SuprithiMarneedi/SELF-POWERED-PIEZOELECTRIC-ENERGY-HARVESTER/open lab poster.pdf

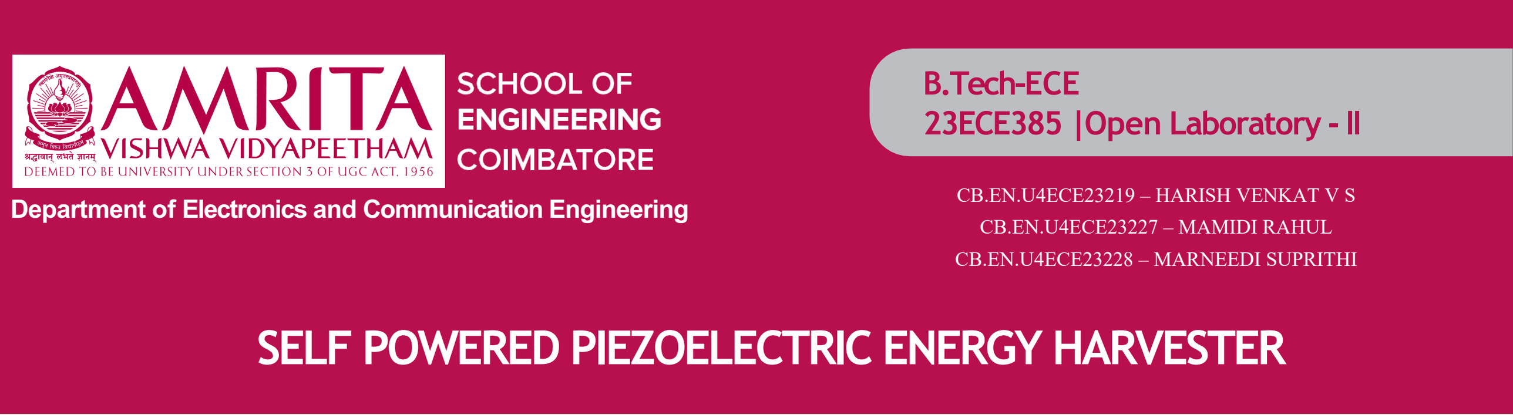
[picture p1: figure]
B.Tech–ECE 23ECE385 |Open Laboratory -II; CB.EN.U4ECE23219 – HARISH VENKAT V S CB.EN.U4ECE23227 – MAMIDI RAHUL CB.EN.U4ECE23228 – MARNEEDI SUPRITHI

# SELF POWERED PIEZOELECTRIC ENERGY HARVESTER

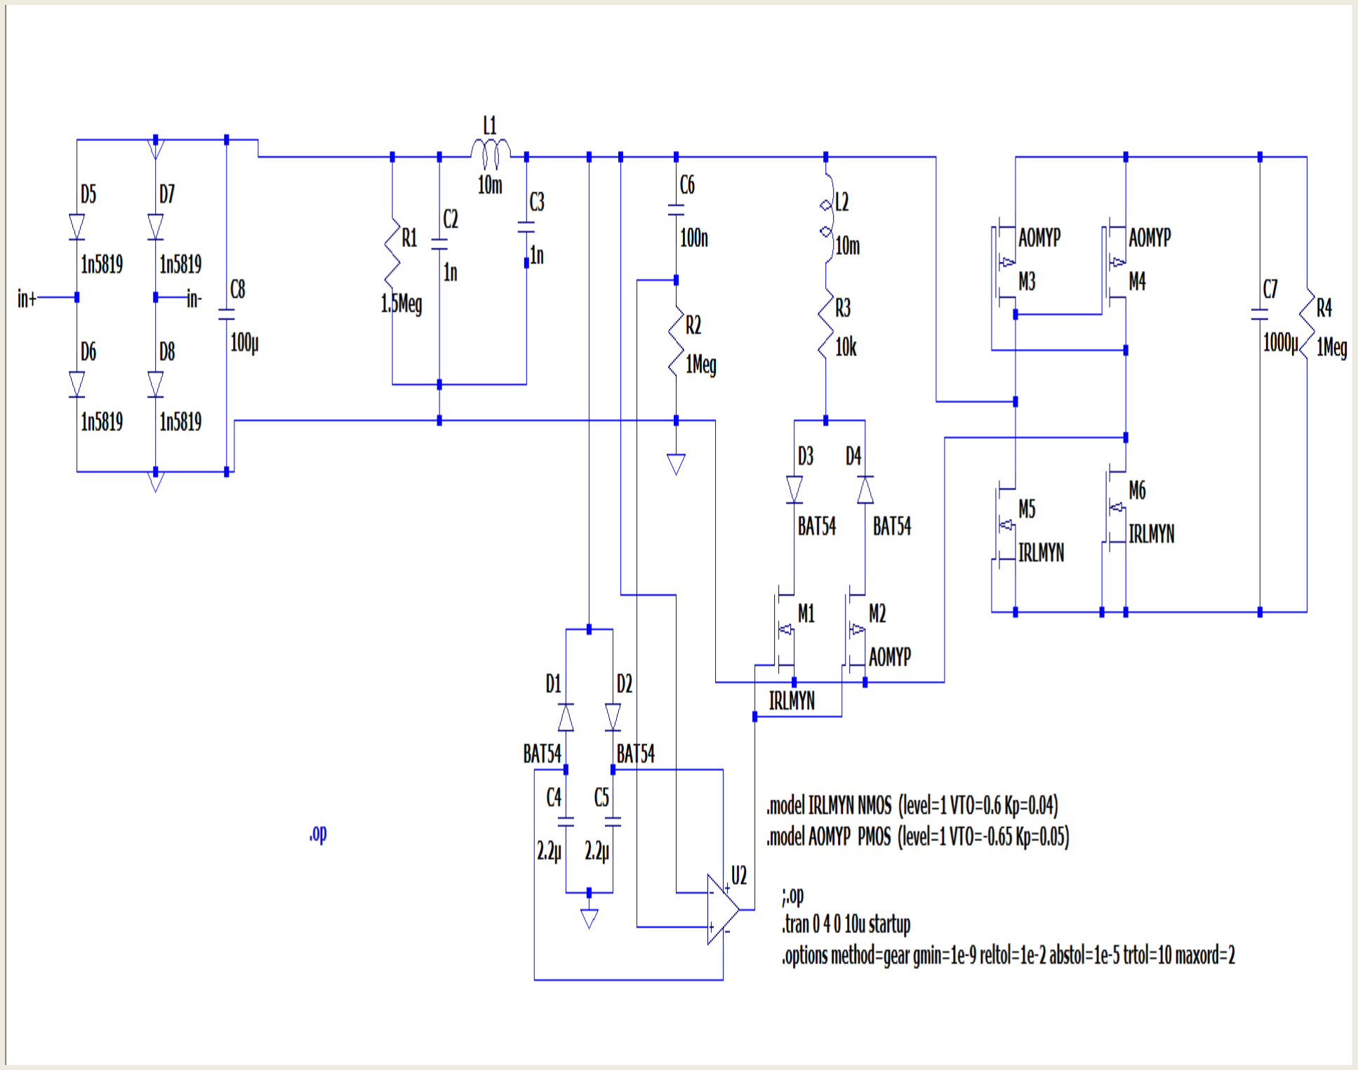
[picture p2: figure]
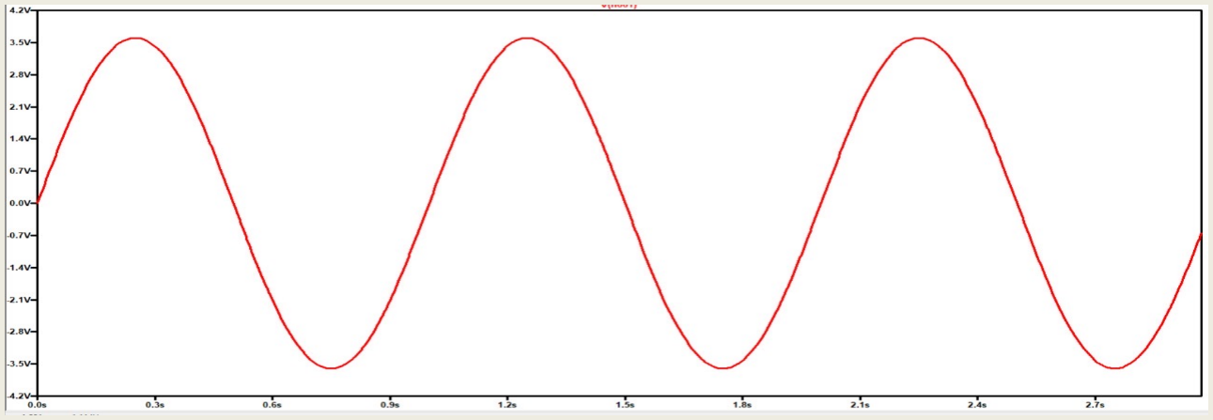
[picture p3: figure]
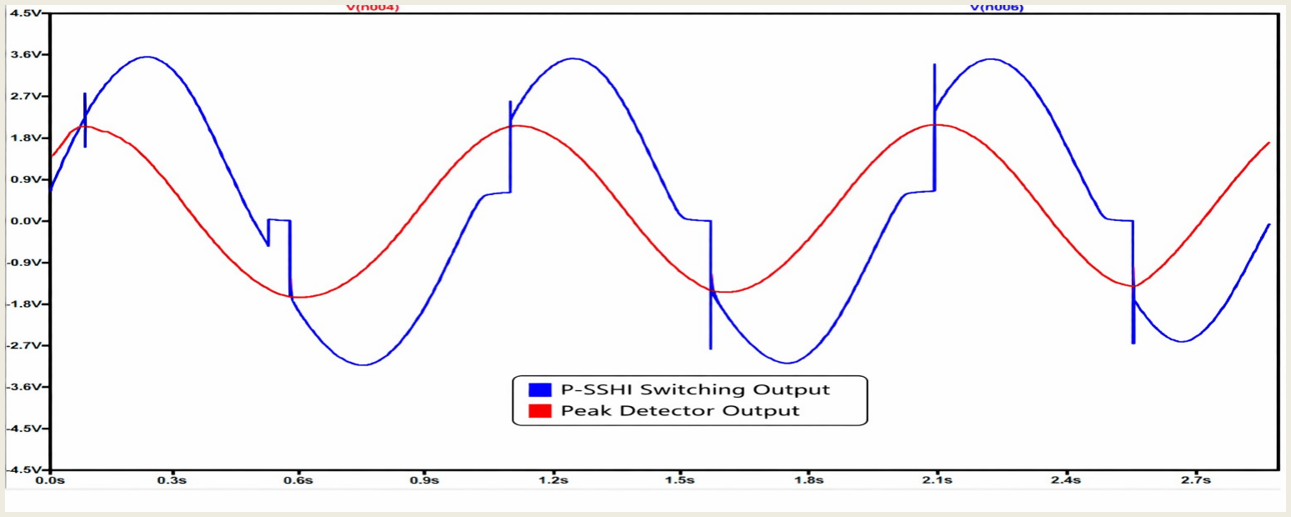
[picture p4: figure]
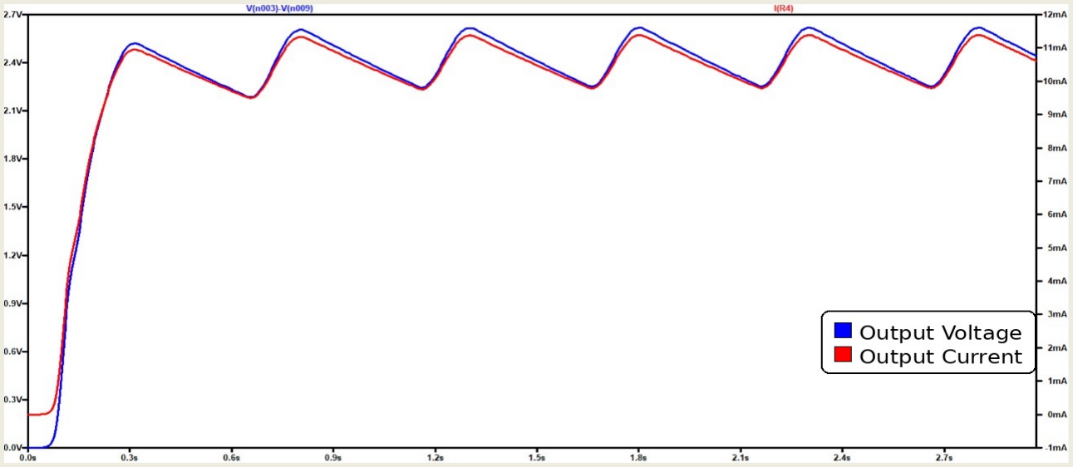
[picture p5: figure]

# Working Model Picture

## Department of Electronics and Communication Engineering

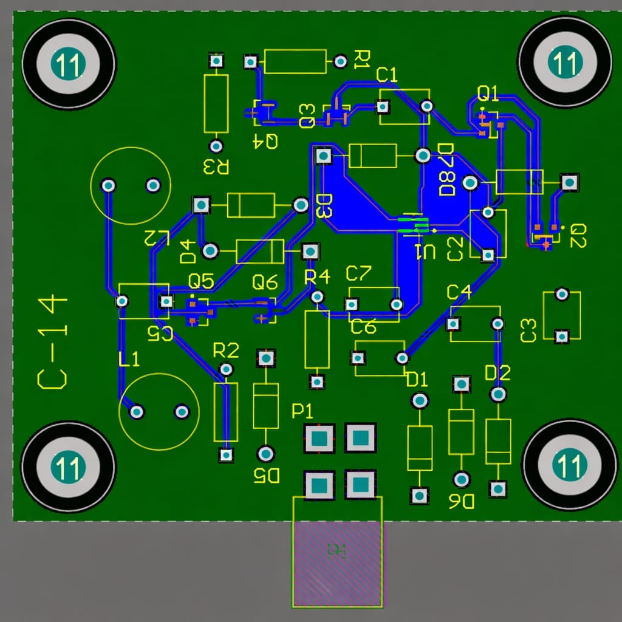
[picture p6: figure]
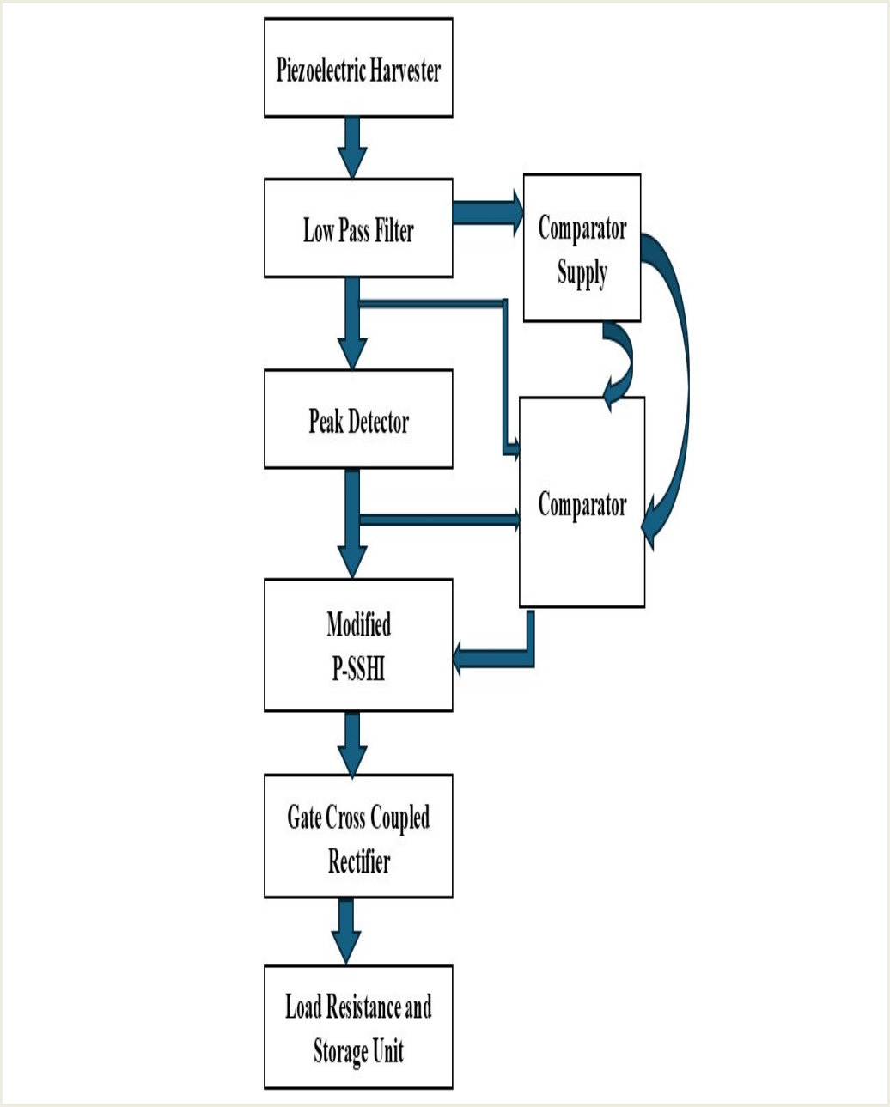
[picture p7: figure]
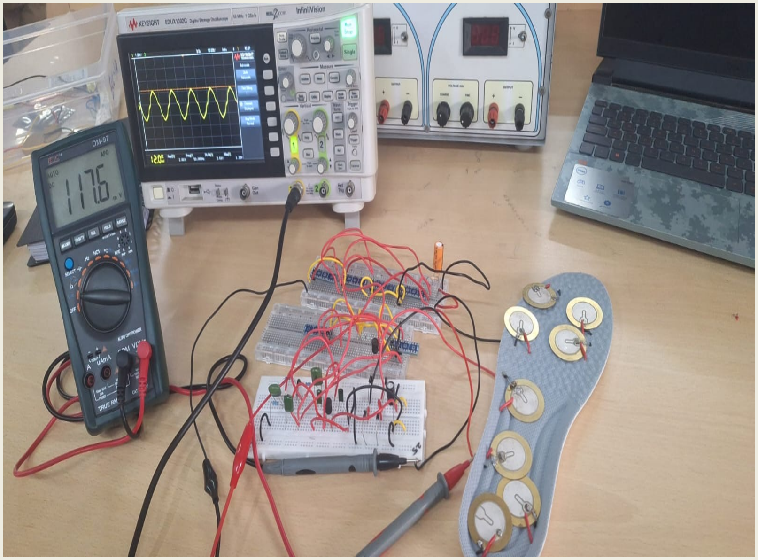
[picture p8: figure]

Batch ID – 23ECE385C14 | | AY 2025-2026 EVEN | Exhibition Date 10/ 3/2026

# Approach / Design / Methodology

# Circuit Diagram /Algorithm

# Simulation Results

# PCB Layout

# Results

# Problem Statement

# References

A | compact, | self-powered, | microcontroller-free
synchronized switching interface circuit (SP-SSHI) using piezoelectric ceramics is developed to harvest irregular and low-frequency mechanical energy from human footsteps. Unlike conventional rectifier-based circuits, this SP-SSHI maximizes harvested energy, reduces losses from impedance mismatch, and stabilizes the output voltage while operating solely on the captured energy. The circuit eliminates the need for batteries, external power, or complex control electronics, enabling efficient, autonomous energy storage and delivery for long-lasting, cost-effective applications in sustainable wearable and sensor systems

FIG 1 – BLOCK DIAGRAM

FIG 2 – CIRCUIT DIAGRAM

- An efficiency-driven architecture was selected to improve power extraction from low-amplitude vibration sources instead of relying on conventional diode rectification.
- A synchronized energy transfer strategy was adopted to ensure switching occurs at optimal waveform instants, reducing energy loss during charge extraction.
- The power processing stage was designed to minimize conduction and switching losses using active rectification techniques.
- The system was structured to enhance charge transfer from the piezoelectric element through controlled voltage inversion.
- Energy accumulation was optimized to convert intermittent vibration inputs into a stable and usable DC output.
- A fully hardware-based implementation was chosen to achieve low power consumption, compactness, and self-powered operation.

FIG 3 - INPUT SIGNAL TO CIRCUIT

FIG 5 - OUTPUT VOLTAGE AND CURRENT

FIG 4 - PEAK DETECTOR AND P-SSHI SWITCHING OUTPUT

FIG 6 – WORKING MODEL OF THE CIRCUIT

FIG 7 – PCB LAYOUT OF THE CIRCUIT

[1] M. Ben Ammar, S. Sahnoun, A. Fakhfakh, C.
Viehweger, | and | O. | Kanoun, | “Self-powered
synchronized switching interface circuit for piezoelectric footstep energy harvesting,” Sensors, vol. 23, no. 4, Art.
no. | 1830, | Feb. | 2023. | [Online]. | Available:
https://doi.org/10.3390/s23041830
[2] H. S. Kim, J.-H. Kim, and J. Kim,“A review of piezoelectric energy harvesting based on vibration,” International Journal of Precision Engineering and Manufacturing, vol. 12, no. 6, pp. 1129–1141, Dec.
2011. | | | [Online]. | | Available:
https://doi.org/10.1007/s12541-011-0151-3
[3] F. Qian, T.-B. Xu, and L. Zuo, “Piezoelectric energy harvesting from human walking using a two-stage amplification mechanism,” Energy, vol. 189, Art. no.
116140, | Sep. | 2019. | [Online]. | Available:
https://doi.org/10.1016/j.energy.2019.116140
[4] S. Chamanian, B. Çiftçi, A. Muhtaroğlu, and H. Külah, “A self-powered and area efficient SSHI rectifier for piezoelectric harvesters,” IEEE Access, vol. 9, pp. 117703–117715, Aug. 2021. [Online]. Available: https://doi.org/10.1109/ACCESS.2021.3107365

•The piezoelectric disc generated an AC output when pressed or tapped, producing a sinusoidal waveform on the DSO.
•The output voltage varied with applied stress, ranging approximately from 60 mV to 200 mV, with each tap producing a clear peak.
•Repeated tapping charged the storage capacitor, and the output remained stable when no stress was applied.

FIG 8 – BEFORE TAPPING FIG 9 – AFTER TAPPING
