SuprithiMarneedi/SELF-POWERED-PIEZOELECTRIC-ENERGY-HARVESTER/C14- Simulation Results.pdf

### SELF POWERED PIEZOELECTRIC ENERGY HARVESTER

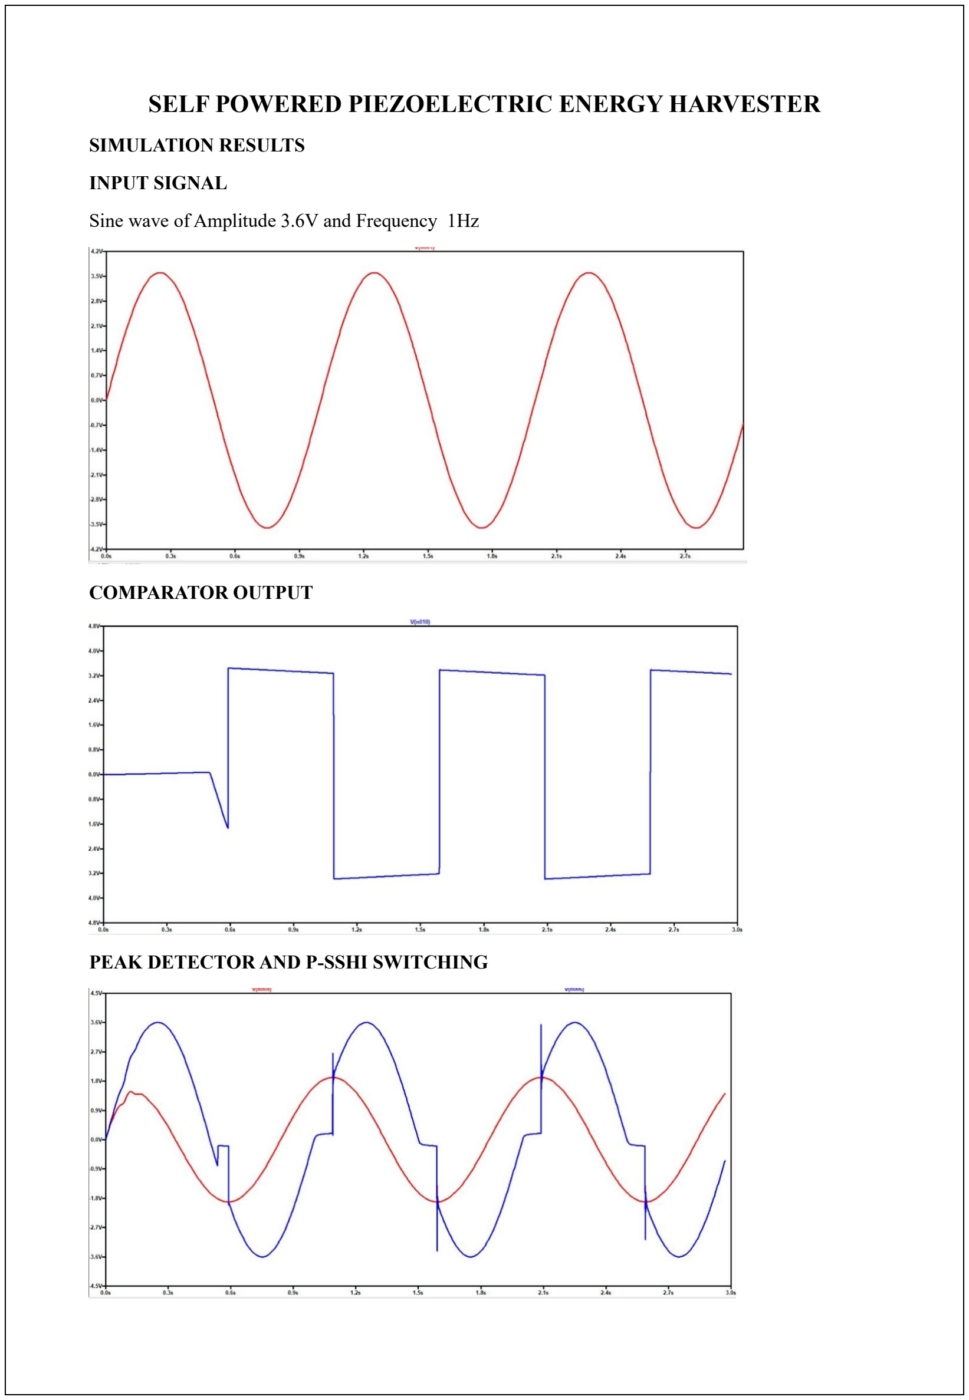
[picture p28: page 1]

SIMULATION RESULTS

INPUT SIGNAL

Sine wave of Amplitude 3.6V and Frequency 1Hz

COMPARATOR OUTPUT

PEAK DETECTOR AND P-SSHI SWITCHING

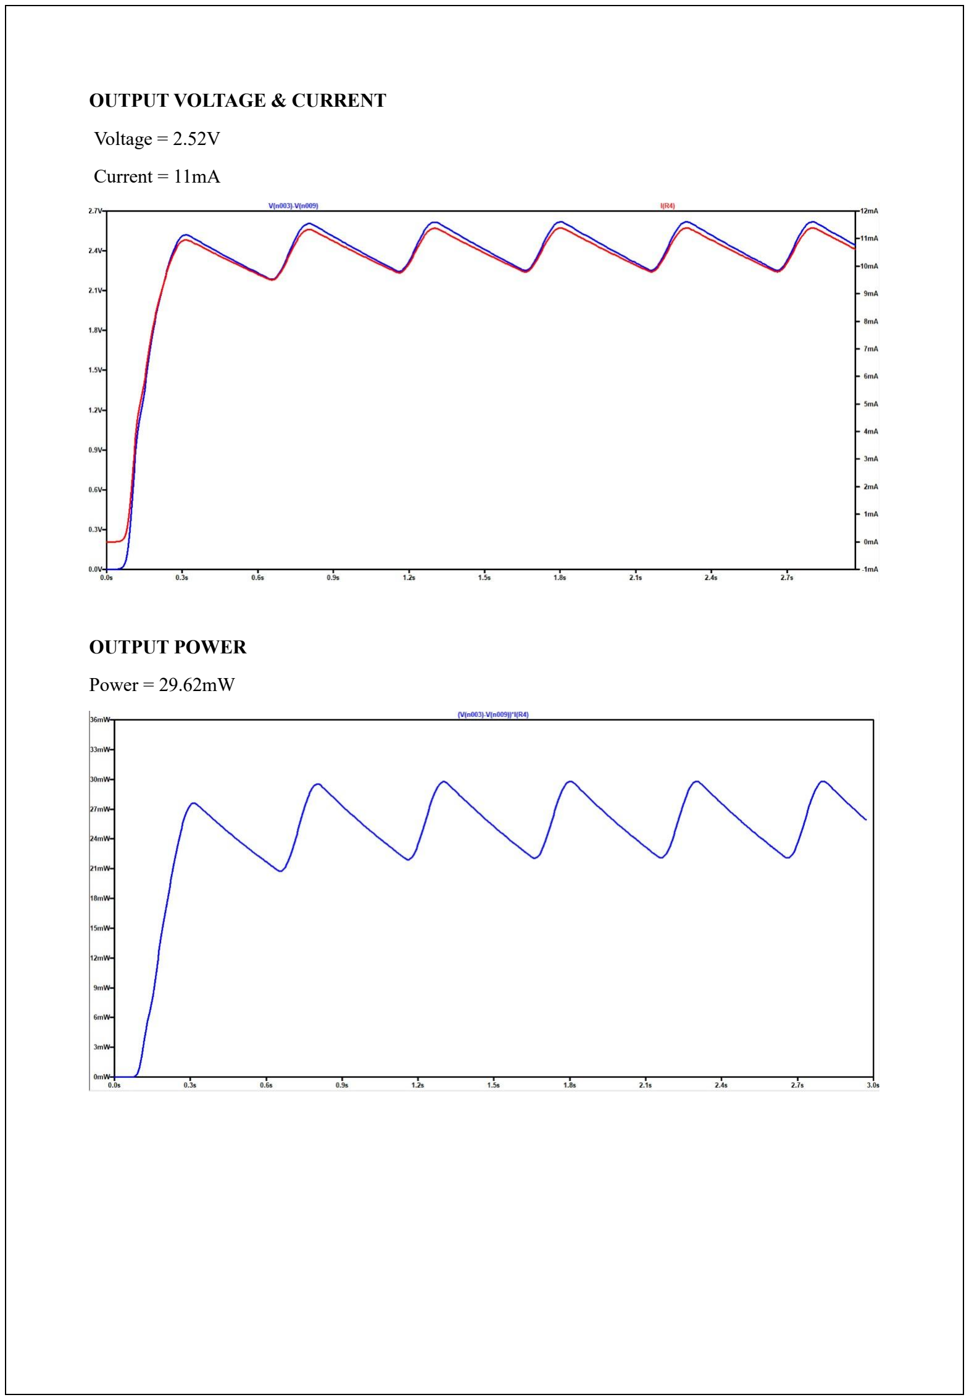
[picture p29: page 2]

OUTPUT VOLTAGE & CURRENT

Voltage = 2.52V

Current = 11mA

OUTPUT POWER

Power = 29.62mW
