SuprithiMarneedi/SELF-POWERED-PIEZOELECTRIC-ENERGY-HARVESTER/FINAL_CIRCUIT.asc

C1: cap; 0.15µ
C2: cap; 1n
C3: cap; 1n
C4: cap; 2.2µ
C5: cap; 2.2µ
C6: cap; 100n
C7: cap; 10m
D1: diode; BAT54
D2: diode; BAT54
D3: diode; BAT54
D4: diode; BAT54
L1: ind; 10m
L2: ind; 10m
M1: nmos; IRLMYN
M2: pmos; AOMYP
M3: pmos; AOMYP
M4: pmos; AOMYP
M5: nmos; IRLMYN
M6: nmos; IRLMYN
R1: res; 1.5Meg
R2: res; 1Meg
R3: res; 10k
R4: res; 230
U2: UniversalOpAmp2
V1: voltage; SINE(0 10 1)
Named nets: 0
.model IRLMYN NMOS  (level=1 VTO=0.6 Kp=0.04)
.model AOMYP  PMOS  (level=1 VTO=-0.65 Kp=0.05)
;.op
.tran 0 4 0 10u startup
.options method=gear gmin=1e-9 reltol=1e-2 abstol=1e-5 trtol=10 maxord=2
.op
